maurik69/diyscip/Kicad_porting/diyscip-v2.kicad_pcb

## KiCad design Kicad_porting/diyscip-v2.kicad_pcb (2021-01-22)

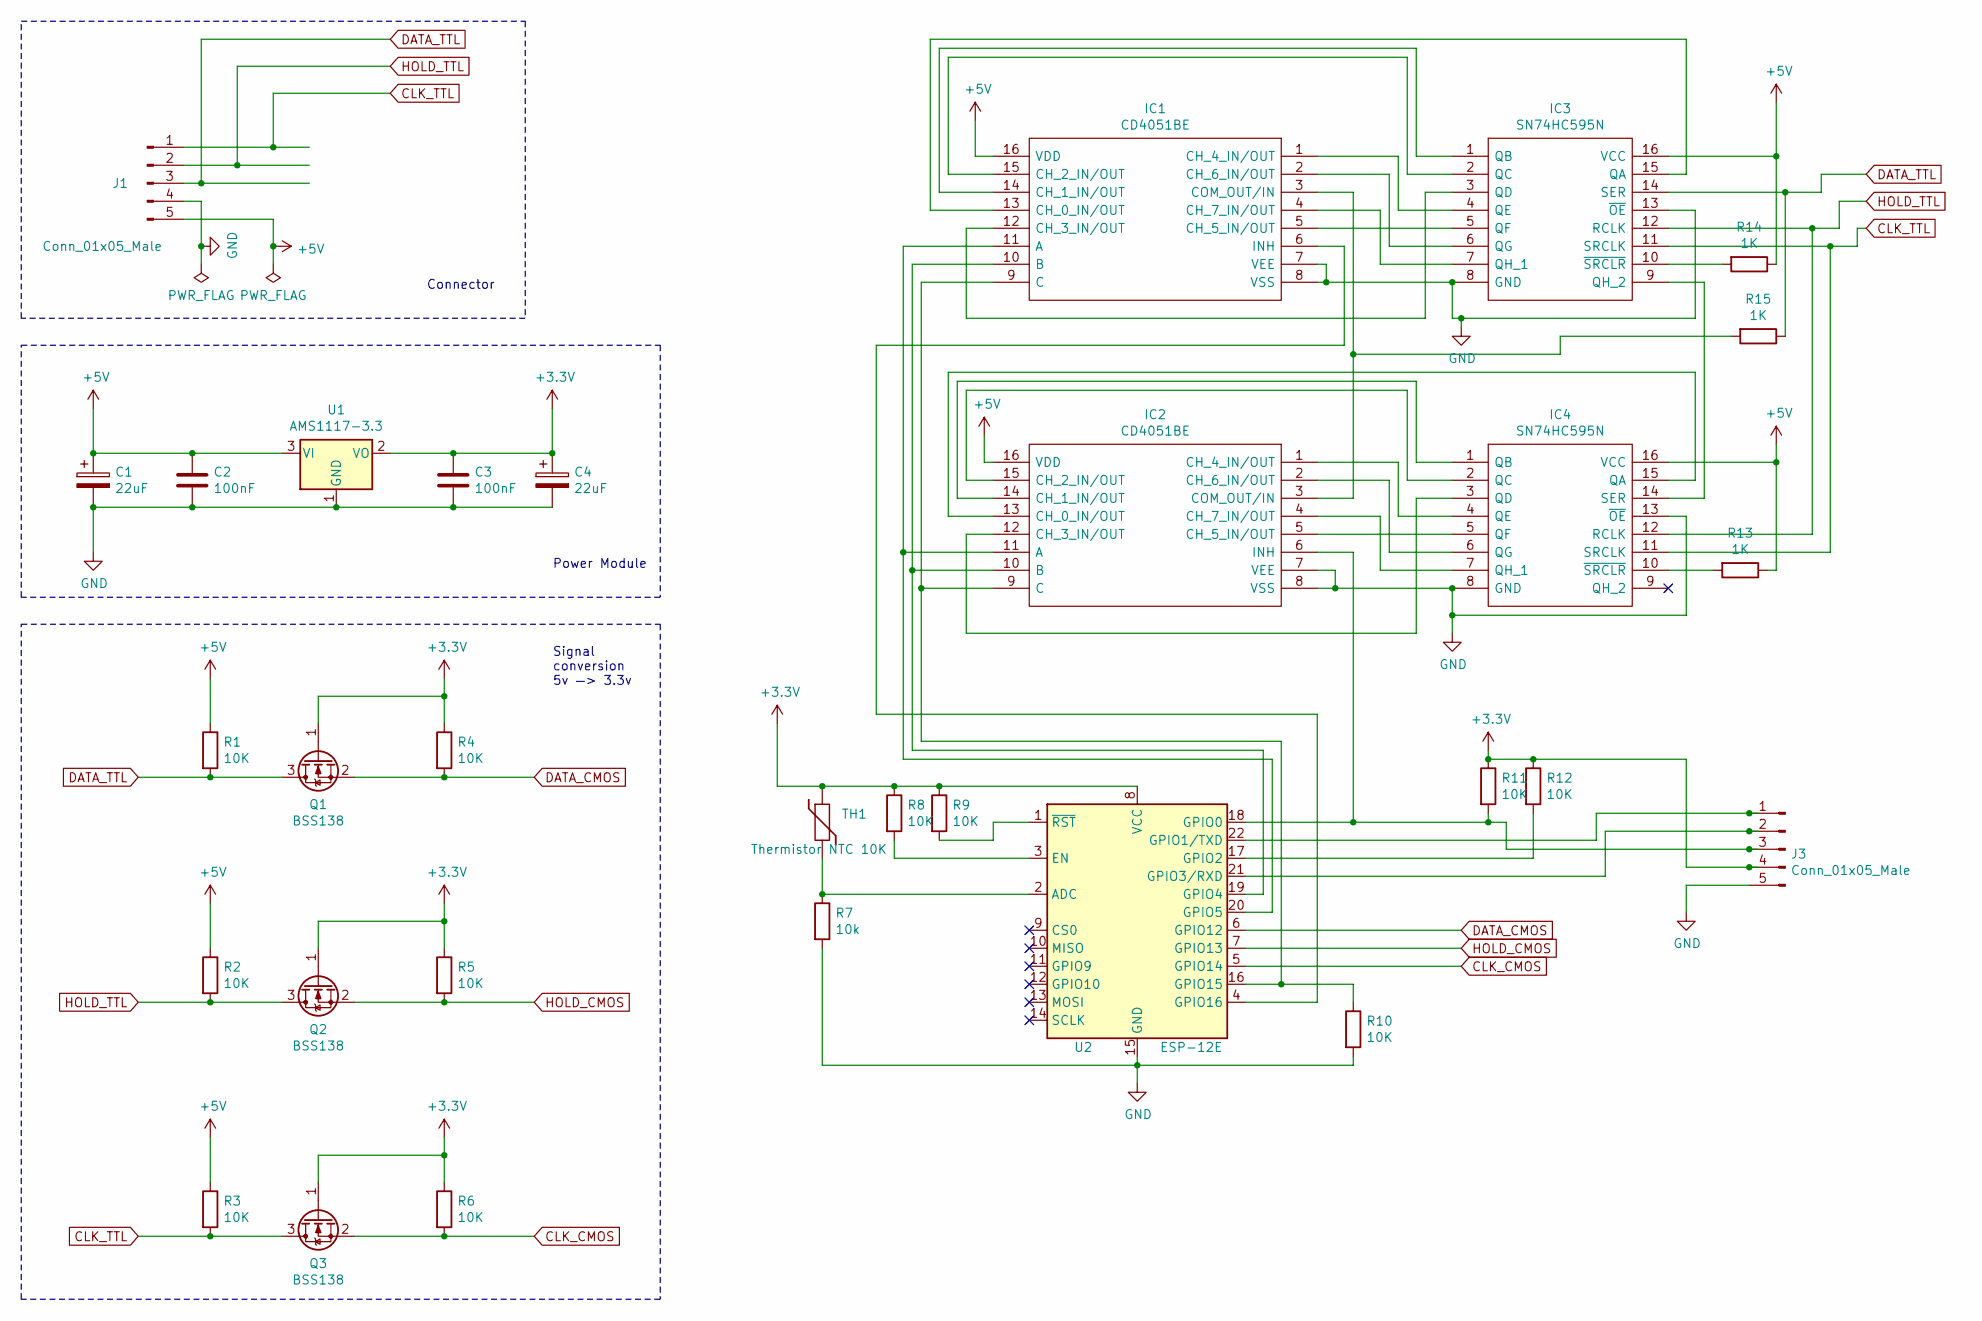
[picture p1: schematic diyscip-v2.sch, Intex Wireless Controller]

Parts:
C1, C4: 22uF; C_1206_3216Metric; LCSC C12891
C2, C3: 100nF; C_0603_1608Metric; LCSC C14663
IC1, IC2: CD4051BE; DIP794W53P254L1930H508Q16N; Mouser Part Number 595-CD4051BE
IC3, IC4: SN74HC595N; DIP794W53P254L1930H508Q16N; Mouser Part Number 595-SN74HC595N
J1: Conn_01x05_Male; JST_VH_B5P-VH-B_1x05_P3.96mm_Vertical
J3: Conn_01x05_Male; PinHeader_1x05_P2.54mm_Vertical
Q1, Q2, Q3: BSS138; SOT-23; LCSC C112239
R1, R2, R3, R4, R5, R6, R8, R9, R10, R11, R12: 10K; R_0603_1608Metric; LCSC C25804
R7: 10k; R_0603_1608Metric; LCSC C25804
R13, R14, R15: 1K; R_0603_1608Metric; LCSC C21190
TH1: Thermistor NTC 10K; R_0603_1608Metric; LCSC C76589
U1: AMS1117-3.3; SOT-223-3_TabPin2; LCSC C6186
U2: ESP-12E; LCSC C82891

Connections:
+3V3: C3.1, C4.1, J3.4, Q1.1 (G), Q2.1 (G), Q3.1 (G), R4.1, R5.1, R6.1, R8.1, R9.1, R11.1, R12.1, TH1.1, U1.2 (VO), U2.8 (VCC)
+5V: C1.1, C2.1, IC1.16 (VDD), IC2.16 (VDD), IC3.16 (VCC), IC4.16 (VCC), J1.5, R1.1, R2.1, R3.1, R13.1, R14.1, U1.3 (VI)
CLK_CMOS: Q3.2 (S), R6.2, U2.5 (GPIO14)
CLK_TTL: IC3.11 (SRCLK), IC4.11 (SRCLK), J1.1, Q3.3 (D), R3.2
DATA_CMOS: Q1.2 (S), R4.2, U2.6 (GPIO12)
DATA_TTL: IC3.14 (SER), J1.3, Q1.3 (D), R1.2, R15.1
GND: C1.2, C2.2, C3.2, C4.2, IC1.7 (VEE), IC1.8 (VSS), IC2.7 (VEE), IC2.8 (VSS), IC3.8 (GND), IC3.13 (~OE), IC4.8 (GND), IC4.13 (~OE), J1.4, J3.5, R7.2, R10.2, U1.1 (GND), U2.15 (GND)
HOLD_CMOS: Q2.2 (S), R5.2, U2.7 (GPIO13)
HOLD_TTL: IC3.12 (RCLK), IC4.12 (RCLK), J1.2, Q2.3 (D), R2.2
unnamed: IC1.1 (CH_4_IN/OUT), IC3.4 (QE)
unnamed: IC1.2 (CH_6_IN/OUT), IC3.6 (QG)
unnamed: IC1.3 (COM_OUT/IN), IC2.3 (COM_OUT/IN), R15.2
unnamed: IC1.4 (CH_7_IN/OUT), IC3.7 (QH_1)
unnamed: IC1.5 (CH_5_IN/OUT), IC3.5 (QF)
unnamed: IC1.6 (INH), U2.4 (GPIO16)
unnamed: IC1.9 (C), IC2.9 (C), R10.1, U2.16 (GPIO15)
unnamed: IC1.10 (B), IC2.10 (B), U2.19 (GPIO4)
unnamed: IC1.11 (A), IC2.11 (A), U2.20 (GPIO5)
unnamed: IC1.12 (CH_3_IN/OUT), IC3.3 (QD)
unnamed: IC1.13 (CH_0_IN/OUT), IC3.15 (QA)
unnamed: IC1.14 (CH_1_IN/OUT), IC3.1 (QB)
unnamed: IC1.15 (CH_2_IN/OUT), IC3.2 (QC)
unnamed: IC2.1 (CH_4_IN/OUT), IC4.4 (QE)
unnamed: IC2.2 (CH_6_IN/OUT), IC4.6 (QG)
unnamed: IC2.4 (CH_7_IN/OUT), IC4.7 (QH_1)
unnamed: IC2.5 (CH_5_IN/OUT), IC4.5 (QF)
unnamed: IC2.6 (INH), J3.3, R11.2, U2.18 (GPIO0)
unnamed: IC2.12 (CH_3_IN/OUT), IC4.3 (QD)
unnamed: IC2.13 (CH_0_IN/OUT), IC4.15 (QA)
unnamed: IC2.14 (CH_1_IN/OUT), IC4.1 (QB)
unnamed: IC2.15 (CH_2_IN/OUT), IC4.2 (QC)
unnamed: IC3.9 (QH_2), IC4.14 (SER)
unnamed: IC3.10 (~SRCLR), R14.2
unnamed: IC4.10 (~SRCLR), R13.2
unnamed: J3.1, U2.22 (GPIO1/TXD)
unnamed: J3.2, U2.21 (GPIO3/RXD)
unnamed: R7.1, TH1.2, U2.2 (ADC)
unnamed: R8.2, U2.3 (EN)
unnamed: R9.2, U2.1 (~RST)
unnamed: R12.2, U2.17 (GPIO2)

Notes on the sheet:
Connector
Power Module
Signal conversion 5v —> 3.3v

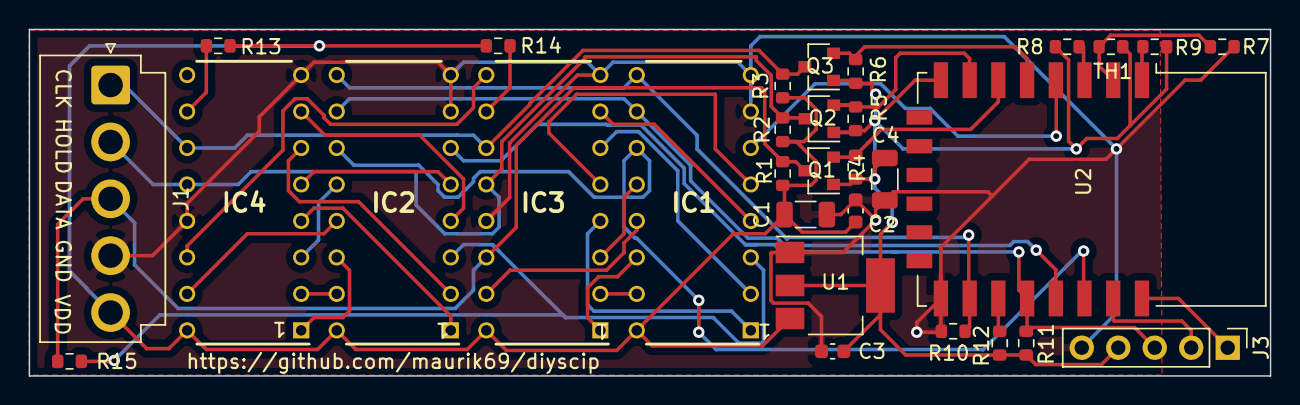
[picture p2: board diyscip-v2.kicad_pcb from above]

Board: 2 copper layers, 86.4 x 24.1 mm, 31 parts (0 on the bottom side), 40 nets.
