maurik69/diyscip/(commit log)

2021-01-02 Kicad porting with JLCPCB files to order new boards
    [JLCSMT_BOM.xlsx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]
2021-01-02 gerber with thermal copper
    [diyscip-v2-B_Cu.gbr, diyscip-v2-B_Mask.gbr, diyscip-v2-B_Paste.gbr, diyscip-v2-B_SilkS.gbr, diyscip-v2-Edge_Cuts.gbr, diyscip-v2-F_Cu.gbr, diyscip-v2-F_Mask.gbr, diyscip-v2-F_Paste.gbr]
2021-01-15 Correzione errore scritta connettore programmazione.
    [diyscip-v2-B_Cu.gbr, diyscip-v2-B_Mask.gbr, diyscip-v2-B_Paste.gbr, diyscip-v2-B_SilkS.gbr, diyscip-v2-Edge_Cuts.gbr, diyscip-v2-F_Cu.gbr, diyscip-v2-F_Mask.gbr, diyscip-v2-F_Paste.gbr]
2021-01-22 Aggiunta resistenza "dimenticata" su segnale DATA
    [diyscip-v2.kicad_pcb, diyscip-v2.sch]
